mirte-robot/mirte-pcb/mirte-bms-breakout/mirte-bms-breakout.step

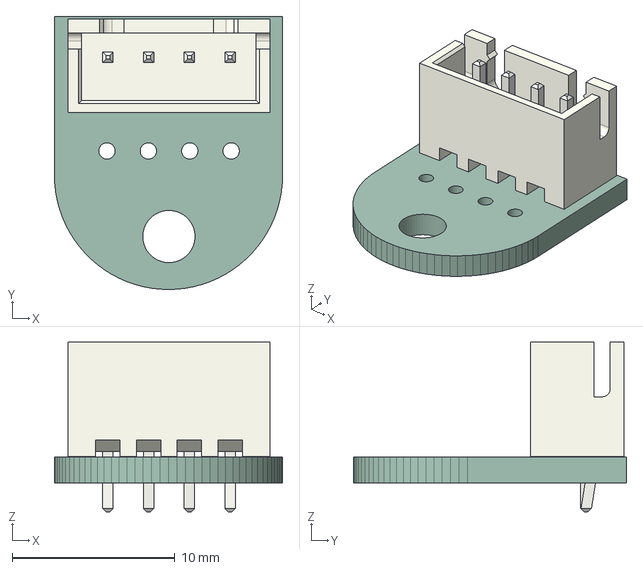
[picture p1: CAD file, 2024-09-20]
mirte-bms-breakout/mirte-bms-breakout.step
14.0 x 16.8 x 10.4 mm
mirte-bms-breakout PCB
