mirte-robot/mirte-pcb/(commit log)

2020-09-27 initial version
    [test_pcb.kicad_pcb, test_pcb.sch]
2020-09-27 fixed some wiring issues
    [test_pcb.kicad_pcb, test_pcb.sch]
2020-09-27 pass design rule check
    [test_pcb.kicad_pcb]
2020-09-28 rerouting, add version number
    [test_pcb.kicad_pcb]
2020-09-28 add 3d model terminal, sync texts ee and pcbn
    [test_pcb.sch]
2020-09-28 add more text
    [test_pcb.kicad_pcb]
2020-09-29 add fancy graphics
    [test_pcb.kicad_pcb]
2020-09-29 replace analog with keypad
    [test_pcb.kicad_pcb, test_pcb.sch]
2020-09-29 add a lot of silk screen
    [test_pcb.kicad_pcb, test_pcb.sch]
2020-09-29 small text change
    [test_pcb.sch]
2020-09-30 removed 1 after keys
    [test_pcb.kicad_pcb, test_pcb.sch]
2020-09-30 martins whatsapp messages
    [test_pcb.kicad_pcb, test_pcb.sch]
2020-09-30 added header for specific motor controller
    [test_pcb.kicad_pcb, test_pcb.sch]
2020-10-01 massive overhoul
    [test_pcb.kicad_pcb]
2020-10-01 small touchups
    [test_pcb.kicad_pcb]
2020-10-01 reversed micro usb
    [test_pcb.kicad_pcb, test_pcb.sch]
2020-10-01 text fix
    [test_pcb.kicad_pcb]
2020-10-01 gnd plane
    [test_pcb.kicad_pcb, test_pcb.sch]
2020-10-01 finishing touches
    [test_pcb.kicad_pcb, test_pcb.sch]
2020-10-02 update measurements. improve ground
    [test_pcb.kicad_pcb, test_pcb.sch]
2020-10-02 moved vias to not interfere with text
    [1825232-1 v7.step, Micro usb_vetical.STEP]
2020-10-02 add motor controller model
    [driver-9110.stp]
2020-10-02 tiny movements
    [Conector USB-A Fêmea PCI 90º.STEP, test_pcb.kicad_pcb]
2020-10-03 cleaner routing
    [test_pcb.kicad_pcb]
2020-10-03 removed via from text
    [test_pcb.kicad_pcb]
2020-10-03 fancy mounting hole
    [test_pcb.kicad_pcb, test_pcb.sch]
2020-10-03 ground shield, order number placement
    [test_pcb.kicad_pcb, test_pcb.sch]
2020-10-04 add models
    [test_pcb.kicad_pcb]
2021-01-10 bump kicad version
    [test_pcb.sch]
2021-01-14 clean up eeschema
    [test_pcb.sch]
2021-01-25 changes v2, ugly routing
    [1825232-1 v7.step, Micro usb_vetical.STEP, driver-9110.stp, test_pcb.kicad_pcb, test_pcb.sch]
2021-01-26 route cleanup
    [test_pcb.kicad_pcb]
2021-01-26 cleaned up some tiny things
    [test_pcb.kicad_pcb]
2021-01-26 small changes to power line
    [test_pcb.kicad_pcb]
2021-01-26 extra servo asssuming b5 works
    [test_pcb.kicad_pcb, test_pcb.sch]
2021-01-26 small text changes
    [test_pcb.kicad_pcb, test_pcb.sch]
2021-02-04 switched i2c, added indicators bottom
    [test_pcb.kicad_pcb, test_pcb.sch]
2021-02-07 routing and shaping, added bom draft
    [test_pcb.kicad_pcb, test_pcb.sch, zoef_price_breakdown.csv]
2021-02-07 fabrication requirements
    [BOM_clean.xlsx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]
2021-10-08 removed gerber files
    [BOM.xlsx, BOM_clean.xlsx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]
2021-10-08 switch some pins around
    [test_pcb.kicad_pcb]
2021-10-08 text changes
    [test_pcb.kicad_pcb]
2021-10-09 changes in eeschema
    [test_pcb.kicad_pcb, test_pcb.sch]
2021-10-23 move 5v out
    [test_pcb.kicad_pcb, test_pcb.sch]
2021-10-23 organized schema
    [test_pcb.sch]
2021-10-23 support for nano
    [test_pcb.kicad_pcb, test_pcb.sch]
2021-10-23 useless but cool looking arrows
    [test_pcb.kicad_pcb]
2021-10-23 massive cleanup
    [test_pcb.kicad_pcb]
2021-10-23 clean up schema after adding nano
    [test_pcb.sch]
2021-10-24 more cleanup
    [test_pcb.kicad_pcb, test_pcb.sch]
2021-10-24 breakout shema
    [test_pcb.kicad_pcb, test_pcb.sch]
2021-11-16 add jst connector
    [test_pcb.kicad_pcb, test_pcb.sch]
2021-11-17 last minute changes, assembly files and fabhouse feedback
    [BOM.xlsx, Mirte_BOM.xlsx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]
2023-06-09 update to pcb v0.6
    [1825232-1 v7.step, Conector USB-A Fêmea PCI 90º.STEP, Micro usb_vetical.STEP, Mirte_BOM.xlsx, driver-9110.stp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]
2023-06-09 Update gitignore for KiCad
2023-06-09 remove unnecesary files after gitignore
    [mirte_combination-B_Cu.gbr, mirte_combination-B_Mask.gbr, mirte_combination-B_Paste.gbr, mirte_combination-B_Silkscreen.gbr, mirte_combination-Edge_Cuts.gbr, mirte_combination-F_Cu.gbr, mirte_combination-F_Mask.gbr, mirte_combination-F_Paste.gbr]
2023-06-09 v0.7: swap encoder1/2<->servo1/2 for PWM fix
    [mirte_combination.kicad_pcb, mirte_combination.kicad_sch]
2023-06-12 Add infill pcb + ignore kidiff
    [mirte_combination.kicad_pcb]
2023-06-30 adapted text, v0.8
    [mirte_combination.kicad_pcb, mirte_combination.kicad_sch]
2023-07-04 Remove generated Gerber zip
2023-12-20 Cleanup mirte pcb + move to folder
    [mirte_combination.kicad_pcb, mirte_combination.kicad_sch]
2023-12-20 start pcb mirte-master
    [mirte-master.kicad_pcb, mirte-master.kicad_sch]
2023-12-20 start mirte-master pcb
    [5vreg.kicad_sch, battery.kicad_sch, encoders.kicad_sch, hbridge_power.kicad_sch, i2c.kicad_sch, imu.kicad_sch, ina226.kicad_sch, led_strip.kicad_sch]
2023-12-21 mirte-master power + start connecting pico
    [encoders.kicad_sch, imu.kicad_sch, ina226.kicad_sch, led_strip.kicad_sch, mirte-master.kicad_sch, oled.kicad_sch, pca9685.kicad_sch, power.kicad_sch]
2023-12-21 First pcb design mirte master
    [5vreg.kicad_sch, battery.kicad_sch, hbridge_power.kicad_sch, imu.kicad_sch, ina226.kicad_sch, led_strip.kicad_sch, mirte-master.kicad_pcb, mirte-master.kicad_sch]
2023-12-22 Shrunk and cleanup
    [battery.kicad_sch, mirte-master.kicad_pcb]
2023-12-22 move sonar pins + workflow
    [mirte-master.kicad_pcb, sonars.kicad_sch]
2023-12-23 kibot kicad 7
2023-12-23 jlc bom
2024-01-15 updates master, holes, components
    [5vreg.kicad_sch, battery.kicad_sch, mirte-master.kicad_pcb, mirte-master.kicad_sch, mirte_combination.kicad_sch]
2024-01-15 add lcsc libs
    [hbridge_power.kicad_sch, mirte-master.kicad_pcb]
2024-01-15 jlcpcb switch, lcsc components
    [mirte-master.kicad_pcb, pca9685.kicad_sch]
2024-01-19 possible extra parts encoder/sonar board
    [mirte-master.kicad_pcb, mirte-master.kicad_sch, motor_conn.kicad_sch, motor_connector.kicad_sch, sonar_conn.kicad_sch, sonar_it.kicad_sch]
2024-01-22 Fix parity schematic pcb
    [mirte_combination.kicad_pcb]
2024-01-22 Add bottom pcb mirte-master
    [encoders.kicad_sch, mirte-master-bottom.kicad_pcb, mirte-master-bottom.kicad_sch, mirte-master.kicad_pcb, mirte-master.kicad_sch, motor.kicad_sch, motor_conn.kicad_sch, motor_connector.kicad_sch]
2024-01-22 jlcpcb fixes mirte-pioneer
    [mirte_combination.kicad_pcb, mirte_combination.kicad_sch]
2024-01-27 Fix pcb file input workflow
2024-01-27 Fix outline bug
    [mirte_combination.kicad_pcb]
2024-01-29 Fix mounting hole location mirte-master-bottom
    [mirte-master-bottom.kicad_pcb, mirte-master-bottom.step]
2024-02-19 upd bottom: add res, 3v3 sonar. mirte-master: change conn, rem res
    [encoders.kicad_sch, mirte-master-bottom.kicad_pcb, mirte-master-bottom.kicad_sch, mirte-master.kicad_pcb, mirte-master.kicad_sch, motor_conn.kicad_sch, motor_connector.kicad_sch, sonar.kicad_sch]
2024-02-19 add kerco/elcos
    [hbridge_power.kicad_sch, ina226.kicad_sch, led_strip.kicad_sch, mirte-master.kicad_pcb, mirte-master.kicad_sch, onOff.kicad_sch, power.kicad_sch, relay.kicad_sch]
2024-02-19 upd rear texts
    [mirte-master.kicad_pcb]
2024-02-19 Fix logo reference name
    [mirte-master.kicad_pcb, mirte_combination.kicad_pcb]
2024-02-19 cleanup connector names
    [mirte-master.kicad_pcb]
2024-02-19 rm ignored files
    [mirte-master-bottom.step]
2024-02-19 mirte master parts jclpcb fixed
    [5vreg.kicad_sch, battery.kicad_sch, encoders.kicad_sch, hbridge_power.kicad_sch, imu.kicad_sch, led_strip.kicad_sch, mirte-master.kicad_pcb, mirte-master.kicad_sch]
2024-02-19 fix mirte-master-bottom pcb parts
    [mirte-master-bottom.kicad_pcb]
2024-02-26 add usb switcher + finalize mirte-master
    [encoders.kicad_sch, mirte-master-bottom.kicad_pcb, mirte-master-bottom.kicad_sch, mirte-master.kicad_pcb, mirte-master.kicad_sch, mirte-usb-switcher.kicad_pcb, mirte-usb-switcher.kicad_sch, motor_conn.kicad_sch]
2024-02-27 move usb switcher
    [mirte-usb-switcher.kicad_pcb, mirte-usb-switcher.kicad_sch]
2024-02-28 usb switcher done
    [mirte-usb-switcher.kicad_pcb, mirte-usb-switcher.kicad_sch]
2024-02-28 Fixes lcsc shortage
    [mirte-master-bottom.kicad_pcb, mirte-usb-switcher.kicad_pcb, mirte-usb-switcher.kicad_sch]
2024-02-28 Fix text unreadable servo 1&2 by move edge
    [mirte_combination.kicad_pcb]
2024-03-01 Final touches before order
    [mirte-master-bottom.kicad_pcb, mirte-master.kicad_pcb, mirte-usb-switcher.kicad_pcb]
2024-03-01 Start bms breakout board
    [mirte-bms-breakout.kicad_pcb, mirte-bms-breakout.kicad_sch, mirte-bms-breakout.step]
2024-03-25 Fix errors(wrong gpio, flipped 5v&gnd)
    [mirte-master.kicad_pcb, mirte-usb-switcher.kicad_pcb, mirte-usb-switcher.kicad_sch]
2024-03-25 rm ref**
    [mirte-master-bottom.kicad_pcb, mirte-master.kicad_pcb]
2024-06-07 Change obj detector to 5V, add header for usb (lego)
    [mirte_combination.kicad_pcb, mirte_combination.kicad_sch]
2024-09-19 update to kicad 8 + test step output
    [mirte_combination.kicad_pcb, mirte_combination.kicad_sch]
2024-09-20 update version8, uart, usb c, usb switch
    [mirte_combination.kicad_pcb, mirte_combination.kicad_sch]
2024-09-20 change switch
    [mirte_combination.kicad_pcb, mirte_combination.kicad_sch]
2024-09-20 Add rotations csv
    [rotations.csv]
2024-09-20 rotations ok
    [mirte_combination.kicad_pcb, rotations.csv]
2024-09-20 start test mirte modules
    [mirte-module.kicad_pcb, mirte-module.kicad_sch]
2024-09-24 styling pioneer pcb 0.9
    [mirte_combination.kicad_pcb]
2024-09-24 remove modules for now
    [mirte-module.kicad_pcb, mirte-module.kicad_sch]
2024-10-15 mirte-master schematic cleanup and readabilityimprovements
    [5vreg.kicad_sch, battery.kicad_sch, encoders.kicad_sch, hbridge_power.kicad_sch, i2c.kicad_sch, imu.kicad_sch, led_strip.kicad_sch, mirte-master.kicad_pcb]
2024-10-15 small adjustments for legibility
    [mirte-master.kicad_sch]
2024-10-15 Change comment uart servos rx tx
    [uart_servos.kicad_sch]
2025-01-06 Fix 5v label OD sensors that are 3v3; Thanks @SuperJappie08
    [mirte_combination.kicad_pcb]
